Hocus-Pocus/Morgan/README.md

# Morgan
2001 Dodge Ram 2500, 4x4, Extended cab, Long box. Originally equiped with the 360CID V8 engine, automatic transmision and Dana 60 HD rear axle. Drive train changed to 1995 Dodge 488CID (8.0L) V 10 engine, NV4500 5 speed manual transmission, Dana 80 limited slip rear axle, custom built programmable EFI.
