Hocus-Pocus/Morgan/Schematics/1995 8.0L PCM Pinouts.xls

1995 8.0L PCM pin outs
CAV | Circuit | Function
1 | K1 DG/RD 18 AWG | MAP Sensor Signal
2 | K2 TN/BK 18 AWG | Engine Coolant Temperature Signal
3 | A14 RD/WT 16 AWG | Fused B(+)
4 | K4 BK/LB 20 AWG | Sensor Ground
5 | N/C | N/C
6 | K6 VT/WT 20 AWG | 5-Volt Supply
7 | K7 OR 20 AWG | 8-Volt Supply
8 | N/C | N/C
9 | F18 LG/BK 20 AWG | Fused Ignition Switch Output (Start/Run)
10 | T6 OR/WT 20 AWG | Trans Overdrive Switch Sense (output)
11 | Z12 BK/TN 16 AWG | Ground
12 | Z12 BK/TN 16 AWG | Ground
13 | K113 LB/BR 20 AWG | Injector #4 Driver (D) (5+8)
14 | K114 YL/WT20 AWG | Injector #3 Driver (C) (3+6)
15 | K115 TN 20 AWG | Injector #1 Driver (A) (9+4)
16 | K116 WT/DB 20 AWG | Injector #2 Driver (B) (1+10)
17 | K18 RD/YL 18 AWG | Ignition Coil #3 Driver (8+9) (4 pak)
18 | K43 DG/GY 20 AWG | Ignition Coil #5 Driver (2+3) (6 pak)
19 | K19 BK/GY 20 AWG | Ignition Coil #1 Driver (1+6) (6 pak)
20 | K20 DG 18 AWG | Generator Field Driver (control)
21 | K21 BK/RD 16 AWG | Intake Air Temperature Signal
22 | K22 OR/DB 18 AWG | Throttle Position Sensor Signal
23 | K141 TN/WT 18 AWG | Left Oxygen Sensor Signal
24 | K24 GY/BK 20 AWG | Crank Position Sensor Signal
25 | D21 PK 20 AWG | SCI Transmit
26 | N/C | N/C
27 | C20 BR 18 AWG | A/C Switch Sense (request)
28 | N/C | N/C
29 | V40 WT/PK 20 AWG | Brake Switch Sense (output)
30 | T41 BK/WT 20 AWG | Park Neutral Sense Switch
31 | T18 LG/OR 20 AWG | Overdrive Lamp Driver (MIL)
32 | G3 BK/PK 20 AWG | Check Engine Lamp Driver
33 | V36 TN/RD 20 AWG | S/C Vacuum Solenoid Control
34 | C13 DB/OR 20 AWG | A/C Compressor Clutch Relay Control
35 | K35 GY/YL 20 AWG | EGR Solenoid control
36 | G14 PK/BK 18 AWG | Trans Temp Lamp Driver
37 | K137 WT/BK 20 AWG | Dwell Gate Driver (Ign Module 4+7, 5+10)
38 | K138 BR/Or 20 AWG | Dwell Signal (Ign Module 4+7, 5+10)
39 | K39 GY/RD 18 AWG | Idle Air Control Motor #3 Driver (D)
40 | K40 BR/WT 18 AWG | Idle Air Control Motor #1 Driver (B)
41 | K41 BK/DG 18 AWG | Right Oxygen Sensor Signal
42 | T54 VT 18 AWG | Trans Fluid Temp Signal
43 | G21 GY/LB 20 AWG | Tachometer Signal
44 | K44 TN/YL 18 AWG | Camshaft Position Sensor Signal
45 | D20 LG 20 AWG | SCI Receive
46 | N/C | N/C
47 | G7 WT/OR 20 AWG | Vehicle Speed Sensor Signal
48 | V31 BR/RD 20 AWG | S/C Coast/Set Switch Sense
49 | V32 YL/RD 20 AWG | S/C On/Off Switch Sense
50 | V33 WT/LG 20 AWG | S/C Resume Switch Sense
51 | K51 DB/YL 20 AWG | Auto Shutdown Relay Control (also Fuel Pump Relay)
52 | K52 PK/BK 20 AWG | Evap Emission Solenoid Control
53 | V35 LG/RD 20 AWG | S/C Vent Solenoid Control
54 | K54 OR/BK 20 AWG | Torque Converter Clutch Solenoid Control
55 | T60 BR 20 AWG | Overdrive Solenoid Control
56 | G24 GY/PK 20 AWG | Check Engine Lamp (Service Engine?)
57 | A142 DG/OR 16 AWG | Auto Shutdown Relay Output
58 | K1458 LG/BK 20 AWG | Injector #5 Driver (E) (7+2)
59 | K59 VT/BK 18 AWG | Idle Air Control Motor #4 Driver (A)
60 | K60 YL/BK 18 AWG | Idle Air Control Motor #2 Driver (C)
Ignition Control Module
 | K17 DB/T 18AWG | Ignition Coil Driver (5+10) (6 pak)
 | K32 YL/GY 18AWG | Ignition Coil Driver (4+7) (4 pak)
