Hocus-Pocus/Morgan/Schematics/1995 Instrument Cluster Pinouts.xls

1995 Instrument Cluster
C215
1 | G19 22 LG/RD | Warning Lamp Driver | Cut and insulate
2 | G107 22 BK/GY | 4WD Switch Output | Cut and insulate (warning lamps now on remote display)
3 | N/C
4 | G4 22 DB | Fuel Level Sensor Signal | Extend and splice
5 | G60 22 GY/YL | Oil Pressure Gauge Sending Unit | Extend and splice
6 | Z11 20 BK/WT | Ground | Extend and splice
7 | F14 20 LG/YL | Fused Ignition Switch Output (Start-Run) | Extend and splice
8 | G29 22 BK/TN | Low Washer Fluid Indicator Lamp | Cut and insulate (warning lamps now on remote display)
9 | G3 22 BK/PK | Malfunction Indicator Lamp | Cut and insulate
10 | G24 22 GY/PK | SRI Driver | Cut and insulate
11 | G6 22 GY | Oil Pressure Warning Lamp Switch | Cut and insulate (warning lamps now on remote display)
12 | G21 22 GY/LB | Tachometer Signal | Extend and splice
13 | N/C
14 | E2 22 OR | Fused Headlamp Switch Output | Extend and splice
C216
1 | L60 20 TN/BK | Right Front Turn Signal | Extend and splice
2 | G34 18 RD/GY | High Beam Indicator Lamp | Extend and splice
3 | L61 20 LG/YL | Left Front Turn Signal | Extend and splice
4 | G7 20 WT/OR | Vehicle Speed Sensor Signal | Extend and splice
5 | Z3 20 BK/OR | Ground | Extend and splice
6 | R41 18 BK/TN | Airbag System Warning Lamp Driver | Cut and insulate
7 | N/C
8 | G20 22 VT/YL | Engine Coolant Temperature Sending Unit | Extend and splice
9 | Z11 20 BK/WT | Ground | Extend and splice
10 | G11 22 WT/BK | Park Brake Sense Switch | Cut and insulate (warning lamps now on remote display)
11 | G9 22 GY/BK | Brake Warning Lamp Driver | Cut and insulate (warning lamps now on remote display)
12 | G54 22 OR/BK | Upshift Lamp Driver | Cut and insulate
13 | N/C
14 | G13 20 DB/RD | Seat Belt Lamp Driver | Cut and insulate (warning lamps now on remote display)
