Hocus-Pocus/Morgan/Schematics/2001 Instrument Cluster Pinouts.xls

2001 Instrument Cluster Pinouts
C1
1 | N/C
2 | G5 22 DB/WT | Fused Ignition Switch Output (Run-Start) | Extend and splice
3 | G11 22 WT/LG | Park Brake Sense Switch | Extend and splice
4 | Z2 20 BK/LG | Ground | Extend and splice
5 | Z3 20 BK/Or | Ground | Extend and splice
6 | F73 20 YL | Fused B (+) | Extend and splice
7 | N/C
8 | G85 22 OR/BK (Diesel) | Wait To Start Warning Indicator Driver | Cut and insulate
9 | D2 20 WT/BK | CCD Bus (-) | Cut and insulate
10 | D1 20 VT/BR | CCD Bus (-) | Cut and insulate
C2
1 | E2 22 OR | Panel Lamps Feed | Extend and splice
2 | G29 22 BK/WT | Washer Fluid Sense | Extend and splice
3 | G10 22 LG/RD | Seat Belt Sense Switch | Extend and splice
4 | N/C
5 | E17 18 YL/BK | Day Brightness Sense | Cut and insulate
6 | L61 18 LG | Left Turn Signal
7 | G13 22 DB/RD | Chime Request Signal | Cut and insulate
8 | L60 18 TN | Right Turn Signal | Extend and splice
9 | G34 16 RD/GY | High Beam Indicator Driver | Extend and splice
10 | G107 22 GY | 4WD Switch Sense | Extend and splice
