Hocus-Pocus/Morgan/Schematics/2001 to 1995 Instrumnent Cluster Connections.xls

2001 Instrument Cluster harness |  |  |  | 1995 instrument cluster connections
C1
1 | N/C | F17 10 Amp
2 | G5 22 DB/WT | Fused Ignition Switch Output (Run-Start) | Extend and splice | C215 | 7 |  |  | F14 20 LG/YL | Fused Ign Switch Out (Start-Run)
3 | G11 22 WT/LG | Park Brake Sense Switch | Extend and splice |  |  |  |  | ? | Future warning panel
4 | Z2 20 BK/LG | Ground | Extend and splice | C215 | 6 | C216 | 9 | Z11 20 BK/WT | Ground
5 | Z3 20 BK/Or | Ground | Extend and splice | C216 | 5 |  |  | Z3 20 BK/OR | Ground
6 | F73 20 YL | Fused B (+) F14 10 Amp | Extend and splice |  |  |  |  | ? | Future warning panel
7 | N/C
8 | G85 22 OR/BK (Diesel) | Wait To Start Warning Indicator Driver | Cut and insulate
9 | D2 20 WT/BK | CCD Bus (-) | Cut and insulate
10 | D1 20 VT/BR | CCD Bus (-) | Cut and insulate
C2
1 | E2 22 OR | Panel Lamps Feed | Extend and splice | C215 | 14 |  |  | E2 22 OR | Fused Headlamp Switch Output
2 | G29 22 BK/WT | Washer Fluid Sense | Extend and splice |  |  |  |  | ? | Future warning panel
3 | G10 22 LG/RD | Seat Belt Sense Switch | Extend and splice |  |  |  |  | ? | Future warning panel
4 | N/C
5 | E17 18 YL/BK | Day Brightness Sense | Cut and insulate
6 | L61 18 LG | Left Turn Signal | Extend and splice | C216 | 3 |  |  | L61 20 LG/YL | Left Front Turn Signal
7 | G13 22 DB/RD | Chime Request Signal | Cut and insulate
8 | L60 18 TN | Right Turn Signal | Extend and splice | C216 | 1 |  |  | L60 20 TN/BK | Right Front Turn Signal
9 | G34 16 RD/GY | High Beam Indicator Driver | Extend and splice | C216 | 2 |  |  | G34 18 RD/GY | High Beam Indicator Lamp
10 | G107 22 GY | 4WD Switch Sense | Extend and splice |  |  |  |  | ? | Future warning panel
