Hocus-Pocus/Morgan/Schematics/MS3 Main DB37 Connections.xls

MS3 | EP100 | MS3 Name | Billy Name | In/Out | Function | Max Amps | DB15 Pin | INJ Pin | MS colour
1 |  | GND | TPS Gnd | GND | TPS Gnd |  |  |  | #20 Bk (shld)
2 |  | GND | N/C | GND | spare GND
3 |  | SPR1 | N/C | (Comms) | (CANH)
4 |  | SPR2 | N/C | (Comms) | (CANL)
5 |  | SPR3 | N/C | spare | spare
6 |  | SPR4 | N/C | spare | spare
7 |  | GND | CKP Gnd | GND | CKP Gnd |  |  |  | #20 Bk (shld)
8 |  | GND | Sensor Gnd | GND | Sensor Gnd |  |  |  | #20 Bk/W
9 |  | GND | N/C | GND | spare GND
10 |  | GND | N/C | GND | spare GND
11 |  | GND | N/C | GND | spare GND
12 |  | GND | N/C | GND | spare GND
13 |  | GND | N/C | GND | spare GND
14 |  | GND | N/C | GND | spare GND
15 |  | GND | N/C | GND | spare GND
16 |  | GND | N/C | GND | spare GND
17 |  | GND | N/C | GND | spare GND
18 |  | GND | Power Gnd | GND | POWER GROUND |  |  |  | #20 Bk
19 |  | GND | Power Gnd | GND | POWER GROUND |  |  |  | #20 Bk
20 | AD1 | MAT | IAT | In | MAT sensor input |  |  |  | #20 W
21 | AD2 | CLT | ECT | In | CLT sensor input |  |  |  | #20 B
22 | AD3 | TPS | TPS | In | TP sensor input |  |  |  | #20 W (shld)
23 | AD5 | O2 | O2 | In | O2/lambda sensor in |  |  |  | #20 W/R
24 | PT0 | TACH IN | CKP | In | "Crank" Tach input |  |  |  | #20 W (shld)
25 |  | IAC1A | IAC1A | (Out) | (IAC1A) | 0.5A
26 |  | TPSVREF 5V | +5V | Out | 5V supply for TPS | 0.1A | 7 |  | #20 R/Gn
27 |  | IAC1B | IAC1B | (Out) | (IAC1B) | 0.5A
28 |  | +12V In | +12VIn | In | Main Power Feed | <1A | 15 |  | #20 R
29 |  | IAC2A | IAC2A | (Out) | (IAC2A) | 0.5A
30 | PP7 | FIDLE | N/C | Out | Idle valve output | 0.1A
31 |  | IAC2B | IAC2B | (Out) | (IAC2B) | 0.5A
32 |  | INJ1 | N/C | Out | Injector Bank 1 output | 7A
33 |  | INJ1 | Inj 7&2 Cntrl | Out | Injector Bank 1 output | 7A |  | F5 | #20 W/R/B
34 |  | Inj2 | N/C | Out | Injector Bank 2 output | 7A
35 |  | INJ2 | N/C | Out | Injector Bank 2 output | 7A
36 |  | IGN | N/C | (Out) | (High current ignition) | 7A
37 |  | FP (Pump) | ASDR/FPR | Out | Fuel pump relay output | 0.1A |  |  | #20 B/WT
NOTE! MS3 Main DB37 pins 18,19 and MS3X DB37 pins 8,12 common to #18 Bk to engine ground
