Hocus-Pocus/Morgan/Schematics/MS3X DB37 Connections.xls

MS3X | EP100 | MS3X Name | Billy Name | In/Out | Function | Max Amp | DB15 Pin | IGN Pin | INJ Pin | MS colour
1 | PA6 | Inj G | INJ 5&8 Cntrl | Out | Injector G output | 5A | 5 |  | F6 | #20 W/Bk/Gn
2 |  | GND | Fuel Prs Gnd | GND | Fuel Prs Gnd
3 |  | GND | Oil Prs Gnd | GND | Oil Prs Gnd
4 | PA5 | Inj F | INJ Spare Cntrl | Out | Injector F output | 5A | 4 |  | F1
5 | PE2 | Flex | N/C | In | Flex Fuel
6 | PP3 | Boost | Generator Field | Out | Mid current output | 3A
7 | PA4 | Inj E | INJ 3&6 Cntrl | Out | Injector E output | 5A | 13 |  | F7 | #20 W/R/Bk
8 |  | GND | GND | GND | POWER GROUND |  |  |  |  | #20 Bk
9 | PP2 | Idle | 8Cyl CMP Out | Out | Mid current output | 3A |  |  |  | #20 B/Bk (NIS insulate)
10 | PA3 | Inj D | N/C | Out | Injector D output | 5A
11 | PK2 | Launch In | VSS1 | In | Ground switch input |  |  |  |  | #20 Gn/Bk to #20 W/Bk
12 |  | GND | GND | GND | POWER GROUND |  |  |  |  | #20 Bk
13 | PA2 | Inj C | INJ 9&4 Cntrl | Out | Injector C output | 5A | 6 |  | F8 | #20 W/Bk
14 | PB0 | Spark A | IGN 1&6 Cntrl | Out | 0-5V logic spark A output | 0.03A | 11 | S4 |  | #20 B
15 | PB2 | Spark C | IGN 9&8 Cntrl | Out | 0-5V logic spark C output | 0.03A | 10 | S7 |  | #20 B/R
16 | PA1 | Inj B | N/C | Out | Injector B output | 5A
17 |  | GND | CMP Gnd | GND | CMP Gnd |  |  |  |  | #20 Bk (shld)
18 | PB6 | Spark G | N/C | Out | 0-5V logic spark G output | 0.03A
19 | PA0 | Inj A | INJ 1&10 Cntrl | Out | Injector A output | 5A | 14 |  | F4 | #20 W/R
20 | PA7 | Inj H | N/C | Out | Injector H output | 5A
21 | AN13 | Spare ADC | Fuel Prs input | In | 0-5V analog input
22 | AN12 | EGO2 | Oil Prs Input | In | 0-5V analog input
23 | AN11 | EXT_MAP | N/C | In | 0-5V analog input
24 | PP4 | Nitrous 1 | A/C Clutch Relay | Out | Mid current output | 3A |  |  |  | #20 R/Bk/W
25 | PP5 | Nitrous 2 | 10Cyl Tach Out | Out | Mid current output | 3A |  |  |  | #20 B/R
26 | PK0 | Tacho | 8Cyl CKP Out | Out | Mid current output | 3A |  |  |  | #20 B/W (NIS insulate)
27 | PP6 | VVT | N/C | Out | Mid current output | 3A
28 | PH6 | Tableswitch in | A/C Request | In | Ground switch input | <1A |  |  |  | #20 W/Bk
29 | PH7 | Nitrous in | N/C | In | +12V switch input | 0.5A
30 | PT6 | Datalog in | N/C | In | Ground switch input | 0.1A
31 | PT4 | PT4 | N/C | In/Out | 0/5V input or output | 0.02A
32 | PT2 | Cam input | CMP Input | In | Cam' Tach input | 7A |  |  |  | #20 W (shld)
33 | PB1 | Spark B | IGN 10&5 Cntrl | Out | 0-5V logic spark B output | 0.03A | 3 | S8 |  | #20 B/W
34 | PB3 | Spark D | IGN 4&7 Cntrl | Out | 0-5V logic spark D output | 0.03A | 2 | S6 |  | #20 B/Bk
35 | PB4 | Spark E | IGN 3&2 Cntrl | Out | 0-5V logic spark E output | 0.03A | 9 | S5 |  | #20 B/W/Or
36 | PB5 | Spark F | IGN Spare Cntrl | Out | 0-5V logic spark F output | 0.03A | 1 | S1
37 | PB7 | Spark H | N/C | Out | 0-5V logic sparkH output | 0.03A
NOTE! IGN pins S2, S3 common to #16 Bk to engine ground
NOTE! INJ pins F2, F3 common to #16 Bk to engine ground
NOTE! MS3X DB37 Pins 8,12 and MS3 Main DB37 pins 18,19 common to #18 Bk to engine ground
