Hocus-Pocus/Morgan/Hardware/Main board/BOM.xls

Item # | Designator | Qty | Mfg | Mfg Part # | Description | Footprint | Type
1 | U301 | 1 | NXP | MC9S12XEP100CAL | Microcontroller | LQFP112 | SMD
