Hocus-Pocus/Morgan/Schematics/Morgan wiring left in harness.xls

F18 18 LG/BK | Fused Igntion Switch Output (Run-Start) | From 10 amp fuse # 9, feeds PCM and fuel pump relay coil
K4 18 BK/LB | Sensor Ground | Connect to MS sensor ground for fuel pump module, possibly others
T41 18 BK/WT | Park Neutral Switch Sense | From ground side of start relay. Ground this, see page 8W-21-2 for clutch switch connection
A14 14 RD/WT | Fused B (+) | From 20 amp fuse #3, feeds PCM and fuel pump relay contact
G7 18 WT/OR | Vehicle Speed Sensor Signal | From PCM to ABS module (redundant)
K30 18 PK | Transmission Control Relay Control | From transmission control relay coil ground side to PCM (redundant)
C13 18 DB/OR | A/C Compressor Clutch Relay Control | From A/C compressor clutch relay coil ground side to PCM (redundant)
K51 18 DB/Yl | Automatic Shutdown Relay Control | From Automatic shutdown relay coil ground side
V36 18 TN/RD | Speed Control Vacuum Solenoid Control | From PCM to speed control servo (redundant)
V35 18 LG/RD | Speed Control Vent Solenoid Control | From PCM to speed control servo (redundant)
K106 18 WT/DG | Leak Detection Pump Solenoid Control | From leak detection pump solenoid ground side (redundant)
V32 18 YL/RD | Speed Control Supply | From PCM to brake switch to speed control servo (redundant)
A142 14 DG/Or | Automatic Shutdown Relay Output | From Automatic shutdown relay output to Injectors, coils and O2 sensors
T6 18 OR/WT | Overdrive Off Sense Switch | From OD Off switch to PCM (redundant)
K107 18 OR | Leak Detection Pump Switch Sense | From generator source at PCM through contacts in leak detection pump to PCM (redundant)
K118 18 PK/Yl | Battery Temperature Sensor Signal | From PCM to battery temperature switch (redundant)
K31 19 BR/WT | Fuel Pump Relay Control | From fuel pump relay coil ground side
K52 18 PK/WT | Evaporative Emission Solenoid Control | From evaporative emission solenoid ground side (redundant)
C90 18 LG WT | A/C Select Input | From PCM. Parallels output from A/C high pressure switch (redundant)
V40 18 WT/PK | Brake Sense Switch | From PCM to ABS controller (redundant)
T125 18 DB | Generator Source | From generator source on PCM to generator field terminal 2 (redundant)
K226 18 DB/WT | Fuel Level Sensor Signal | From Fuel pump module to PCM
D21 18 PK/DB | SCI Transmit | To Data Link Connector (redundant)
D2 18 Wt/Bk | CCD Bus (-) | See note below
D20 18 DG | SCI Receive | To Data Link Connector (redundant)
D1 18 VT/BR | CCD Bus (+) | See note below
V37 18 RD/LG | Speed Control Switch Signal | From PCM to speed control switches (redundant)
Z12 18 BK/TN | Ground | To Data Link Connector (redundant)
A141 18 DG/WT | Automatic Shutdown Relay Output | To O2 Sensors (redundant)
T16 18 RD | Transmission Control Relay Output | From transmission control relay contact to solenoid assembly (redundant)
L10 18 BR/LG | Fused Ignition Switch Output (Run) | From 10 amp fuse #7 back up lamp supply
T41 18 BK/WT | Park Neutral Position Switch Sense | From ground side of start relay coil to park Neutral switch (redundant)
L1 18 VT/BK | Backup Lamp Feed | To back up lamps
C3 22 DB/BK | A/C Compressor Clutch | Output from A/C Compressor Clutch Relay
NOTE! CCD bus links PCM, Air Bag Control, Radio, Overhead Consol, Central Timer Module, ABS Module and Instrument Cluster
