Hocus-Pocus/Morgan/Hardware/Auxiliary board/BPEM488CWaux.kicad_pcb

## KiCad design Hardware/Auxiliary board/BPEM488CWaux.kicad_pcb (2022-11-16)

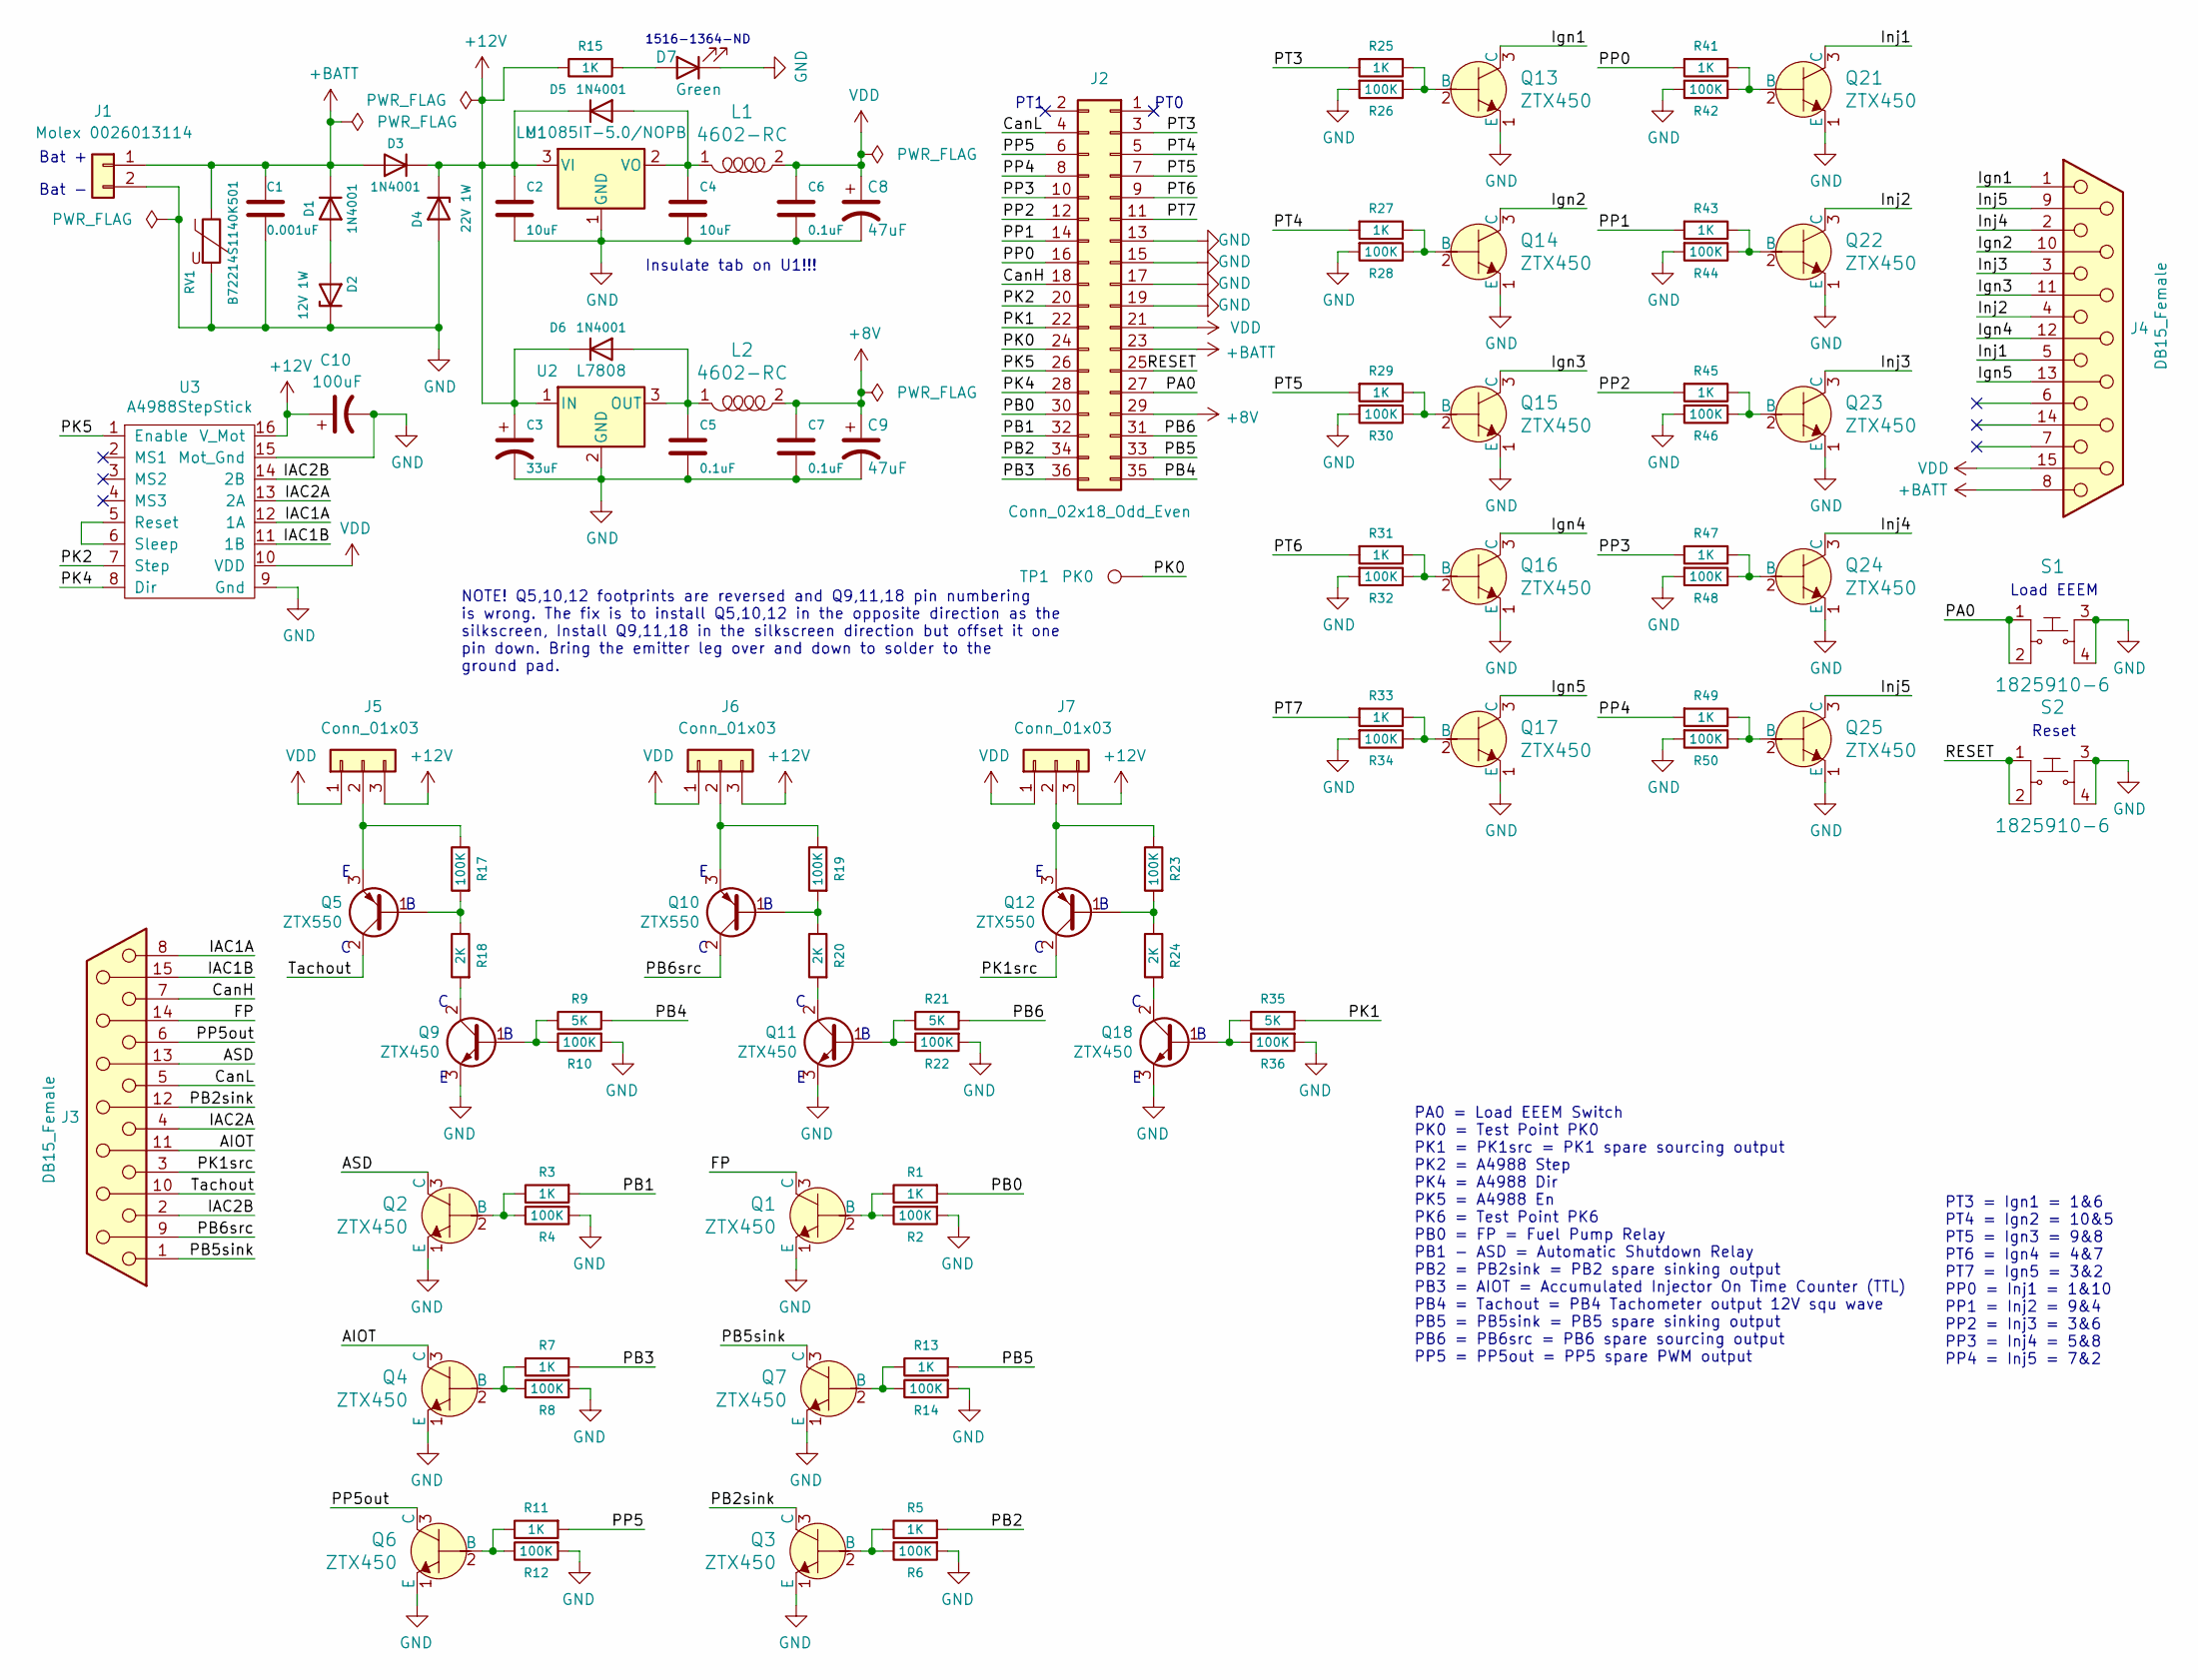
[picture p1: schematic BPEM488CWaux.sch]

Parts:
C1: 0.001uF; C_Disc_D3.8mm_W2.6mm_P2.50mm; Digikey 399-13913-2-ND
C2, C4: 10uF; C_Disc_D5.0mm_W2.5mm_P2.50mm; Digikey 399-13950-ND
C3: 33uF; CP_Radial_Tantal_D8.0mm_P5.00mm; Digikey 399-3591-ND
C5, C6, C7: 0.1uF; C_Disc_D5.0mm_W2.5mm_P2.50mm; Digikey 399-4264-ND
C8, C9: 47uF; CP_Radial_Tantal_D8.0mm_P5.00mm; Digikey 399-3596-ND
C10: 100uF; CP_Radial_Tantal_D8.0mm_P5.00mm; Digikey 399-3596-ND
D1, D3, D5, D6: 1N4001; D_DO-41_SOD81_P7.62mm_Horizontal; Digikey 1N4001DICT-ND
D2: 12V 1W; D_DO-41_SOD81_P7.62mm_Horizontal; Digikey 1727-3635-2-ND
D4: 22V 1W; D_DO-41_SOD81_P7.62mm_Horizontal; Digikey MAZ222000GTR-ND
D7: Green; LED_D5.0mm; Digikey 1516-1364-ND
J1: Molex 0026013114; Molex_Mini-Fit_Jr_5569-02A2_2x01_P4.20mm_Horizontal; Digikey WM14505-ND
J2: Conn_02x18_Odd_Even; PinSocket_2x18_P2.54mm_Vertical
J3, J4: DB15_Female; DSUB-15_Female_Horizontal_P2.77x2.84mm_EdgePinOffset7.70mm_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; Digikey A32123-ND
J5, J6, J7: Conn_01x03; PinHeader_1x03_P2.54mm_Vertical
L1, L2: 4602-RC; L_Axial_L16.0mm_D6.3mm_P25.40mm_Horizontal_Fastron_VHBCC; Digikey 4602-RC-ND
Q1, Q2, Q3, Q4, Q6, Q7, Q13, Q14, Q15, Q16, Q17, Q21, Q22, Q23, Q24, Q25: ZTX450; MPN ZTX450; Digi-Key_PN ZTX450-ND
Q5, Q10, Q12: ZTX550
Q9, Q11, Q18: ZTX450
R1, R3, R5, R7, R11, R13, R15, R25, R27, R29, R31, R33, R41, R43, R45, R47, R49: 1K; R_Axial_DIN0207_L6.3mm_D2.5mm_P10.16mm_Horizontal; Digikey 1.00KXBK-ND
R2, R4, R6, R8, R10, R12, R14, R22, R26, R28, R30, R32, R34, R36, R42, R44, R46, R48, R50: 100K; R_Axial_DIN0207_L6.3mm_D2.5mm_P10.16mm_Horizontal; Digikey 100KXBK-ND
R9, R21, R35: 5K; R_Axial_DIN0207_L6.3mm_D2.5mm_P10.16mm_Horizontal; Digikey 1.00KXBK-ND
R17, R19, R23: 100K; R_Axial_DIN0207_L6.3mm_D2.5mm_P10.16mm_Horizontal; Digikey 1.00KXBK-ND
R18, R20, R24: 2K; R_Axial_DIN0207_L6.3mm_D2.5mm_P10.16mm_Horizontal; Digikey 1.00KXBK-ND
RV1: B72214S1140K501; RV_Disc_D15.5mm_W3.9mm_P7.5mm; Digikey 495-2057-ND
S1, S2: 1825910-6; Switch_Tactile_THT_6x6mm; MPN 1825910-6; Digi-Key_PN 450-1650-ND
TP1: PK0; PinHeader_1x01_P2.54mm_Vertical
U1: LM1085IT-5.0/NOPB; LM1085
U2: L7808
U3: A4988StepStick

Connections:
+8V: C7.1, C9.1, J2.29, L2.2
+12V: C2.1, C3.1, C10.1, D3.1 (K), D4.1 (K), D5.1 (K), D6.1 (K), J5.3, J6.3, J7.3, R15.1, U1.3 (VI), U2.1 (IN), U3.16 (V_Mot)
+BATT: C1.1, D1.1 (K), D3.2 (A), J1.1, J2.23, J4.8, RV1.1
/AIOT: J3.11 (P111), Q4.3 (C)
/ASD: J3.13, Q2.3 (C)
/CanH: J2.18, J3.7
/CanL: J2.4, J3.5
/FP: J3.14, Q1.3 (C)
/IAC1A: J3.8, U3.12 (1A)
/IAC1B: J3.15, U3.11 (1B)
/IAC2A: J3.4, U3.13 (2A)
/IAC2B: J3.2, U3.14 (2B)
/Ign1: J4.1, Q13.3 (C)
/Ign2: J4.10, Q14.3 (C)
/Ign3: J4.11 (P111), Q15.3 (C)
/Ign4: J4.12, Q16.3 (C)
/Ign5: J4.13, Q17.3 (C)
/Inj1: J4.5, Q21.3 (C)
/Inj2: J4.4, Q22.3 (C)
/Inj3: J4.3, Q23.3 (C)
/Inj4: J4.2, Q24.3 (C)
/Inj5: J4.9, Q25.3 (C)
/PA0: J2.27, S1.1, S1.2
/PB0: J2.30, R1.2
/PB1: J2.32, R3.2
/PB2: J2.34, R5.2
/PB2sink: J3.12, Q3.3 (C)
/PB3: J2.36, R7.2
/PB4: J2.35, R9.2
/PB5: J2.33, R13.2
/PB5sink: J3.1, Q7.3 (C)
/PB6: J2.31, R21.2
/PB6src: J3.9, Q10.2 (C)
/PK0: J2.24, TP1.1
/PK1: J2.22, R35.2
/PK1src: J3.3, Q12.2 (C)
/PK2: J2.20, U3.7 (Step)
/PK4: J2.28, U3.8 (Dir)
/PK5: J2.26, U3.1 (Enable)
/PP0: J2.16, R41.2
/PP1: J2.14, R43.2
/PP2: J2.12, R45.2
/PP3: J2.10, R47.2
/PP4: J2.8, R49.2
/PP5: J2.6, R11.2
/PP5out: J3.6, Q6.3 (C)
/PT3: J2.3, R25.2
/PT4: J2.5, R27.2
/PT5: J2.7, R29.2
/PT6: J2.9, R31.2
/PT7: J2.11, R33.2
/RESET: J2.25, S2.1, S2.2
/Tachout: J3.10, Q5.2 (C)
GND: C1.2, C2.2, C3.2, C4.2, C5.2, C6.2, C7.2, C8.2, C9.2, C10.2, D2.1 (K), D4.2 (A), D7.1 (K), J1.2, J2.13, J2.15, J2.17, J2.19, Q1.1 (E), Q2.1 (E), Q3.1 (E), Q4.1 (E), Q6.1 (E), Q7.1 (E), Q9.3 (E), Q11.3 (E), Q13.1 (E), Q14.1 (E), Q15.1 (E), Q16.1 (E), Q17.1 (E), Q18.3 (E), Q21.1 (E), Q22.1 (E), Q23.1 (E), Q24.1 (E), Q25.1 (E), R2.2, R4.2, R6.2, R8.2, R10.2, R12.2, R14.2, R22.2, R26.2, R28.2, R30.2, R32.2, R34.2, R36.2, R42.2, R44.2, R46.2, R48.2, R50.2, RV1.2, S1.3, S1.4, S2.3, S2.4, U1.1 (GND), U2.2 (GND), U3.9 (Gnd), U3.15 (Mot_Gnd)
unnamed: C4.1, D5.2 (A), L1.1, U1.2 (VO)
unnamed: C5.1, D6.2 (A), L2.1, U2.3 (OUT)
unnamed: D1.2 (A), D2.2 (A)
unnamed: D7.2 (A), R15.2
unnamed: J5.2, Q5.3 (E), R17.1
unnamed: J6.2, Q10.3 (E), R19.1
unnamed: J7.2, Q12.3 (E), R23.1
unnamed: Q1.2 (B), R1.1, R2.1
unnamed: Q2.2 (B), R3.1, R4.1
unnamed: Q3.2 (B), R5.1, R6.1
unnamed: Q4.2 (B), R7.1, R8.1
unnamed: Q5.1 (B), R17.2, R18.1
unnamed: Q6.2 (B), R11.1, R12.1
unnamed: Q7.2 (B), R13.1, R14.1
unnamed: Q9.1 (B), R9.1, R10.1
unnamed: Q9.2 (C), R18.2
unnamed: Q10.1 (B), R19.2, R20.1
unnamed: Q11.1 (B), R21.1, R22.1
unnamed: Q11.2 (C), R20.2
unnamed: Q12.1 (B), R23.2, R24.1
unnamed: Q13.2 (B), R25.1, R26.1
unnamed: Q14.2 (B), R27.1, R28.1
unnamed: Q15.2 (B), R29.1, R30.1
unnamed: Q16.2 (B), R31.1, R32.1
unnamed: Q17.2 (B), R33.1, R34.1
unnamed: Q18.1 (B), R35.1, R36.1
unnamed: Q18.2 (C), R24.2
unnamed: Q21.2 (B), R41.1, R42.1
unnamed: Q22.2 (B), R43.1, R44.1
unnamed: Q23.2 (B), R45.1, R46.1
unnamed: Q24.2 (B), R47.1, R48.1
unnamed: Q25.2 (B), R49.1, R50.1
unnamed: U3.5 (Reset), U3.6 (Sleep)
VDD: C6.1, C8.1, J2.21, J4.15, J5.1, J6.1, J7.1, L1.2, U3.10 (VDD)

Notes on the sheet:
Load EEEM
Reset
Bat -
Bat +
PA0 = Load EEEM Switch PK0 = Test Point PK0 PK1 = PK1src = PK1 spare sourcing output PK2 = A4988 Step PK4 = A4988 Dir PK5 = A4988 En PK6 = Test Point PK6 PB0 = FP = Fuel Pump Relay PB1 - ASD = Automatic Shutdown Relay PB2 = PB2sink = PB2 spare sinking output PB3 = AIOT = Accumulated Injector On Tim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
PT3 = Ign1 = 1&6 PT4 = Ign2 = 10&5 PT5 = Ign3 = 9&8 PT6 = Ign4 = 4&7 PT7 = Ign5 = 3&2 PP0 = Inj1 = 1&10 PP1 = Inj2 = 9&4 PP2 = Inj3 = 3&6 PP3 = Inj4 = 5&8 PP4 = Inj5 = 7&2
Insulate tab on U1!!!
PT0
PT1
1516-1364-ND
NOTE! Q5,10,12 footprints are reversed and Q9,11,18 pin numbering is wrong. The fix is to install Q5,10,12 in the opposite direction as the silkscreen, Install Q9,11,18 in the silkscreen direction but offset it one pin down. Bring the emitter leg over and down to solder to the ground pad.

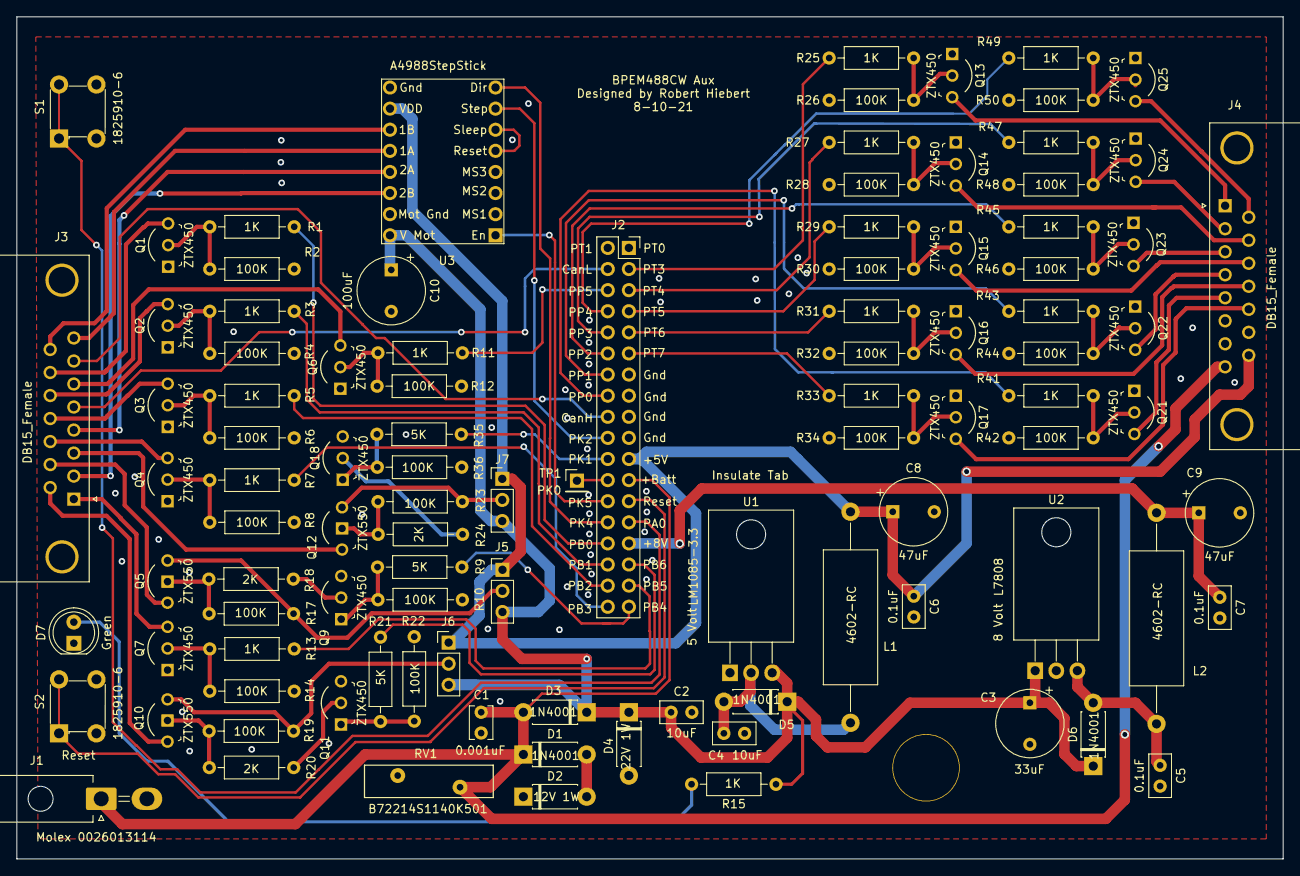
[picture p2: board BPEM488CWaux.kicad_pcb from above]

Board: 2 copper layers, 152.4 x 101.3 mm, 100 parts (0 on the bottom side), 88 nets.
