Hocus-Pocus/Morgan/Hardware/Main board/BPEM488CW.kicad_pcb

## KiCad design Hardware/Main board/BPEM488CW.kicad_pcb (2022-11-16)

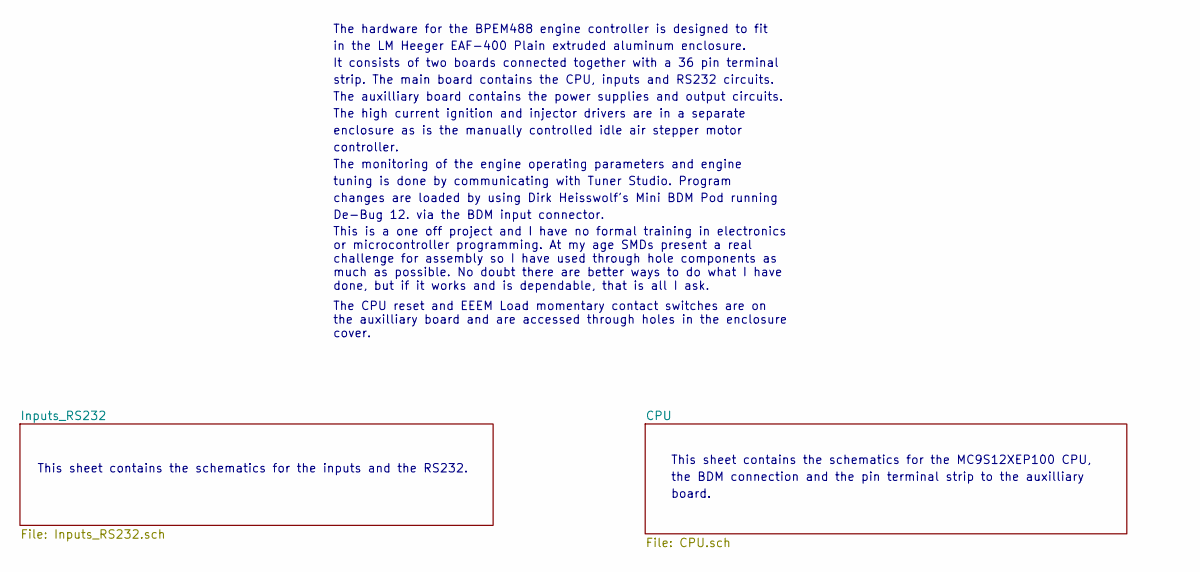
[picture p3: schematic BPEM488CW.sch]

Notes on the sheet:
This sheet contains the schematics for the MC9S12XEP100 CPU,
the BDM connection and the pin terminal strip to the auxilliary
board.
This sheet contains the schematics for the inputs and the RS232.
The hardware for the BPEM488 engine controller is designed to fit
in the LM Heeger EAF-400 Plain extruded aluminum enclosure.
It consists of two boards connected together with a 36 pin terminal
strip. The main board contains the CPU, inputs and RS232 circuits.
The auxilliary board contains the power supplies and output circuits.
The high current ignition and injector drivers are in a separate
enclosure as is the manually controlled idle air stepper motor
controller.
The monitoring of the engine operating parameters and engine
tuning is done by communicating with Tuner Studio. Program
changes are loaded by using Dirk Heisswolf's Mini BDM Pod running
De-Bug 12. via the BDM input connector.
This is a one off project and I have no formal training in electronics or microcontroller programming. At my age SMDs present a real challenge for assembly so I have used through hole components as much as possible. No doubt there are better ways to do what I have done, but if it works and is depen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
The CPU reset and EEEM Load momentary contact switches are on the auxilliary board and are accessed through holes in the enclosure cover.

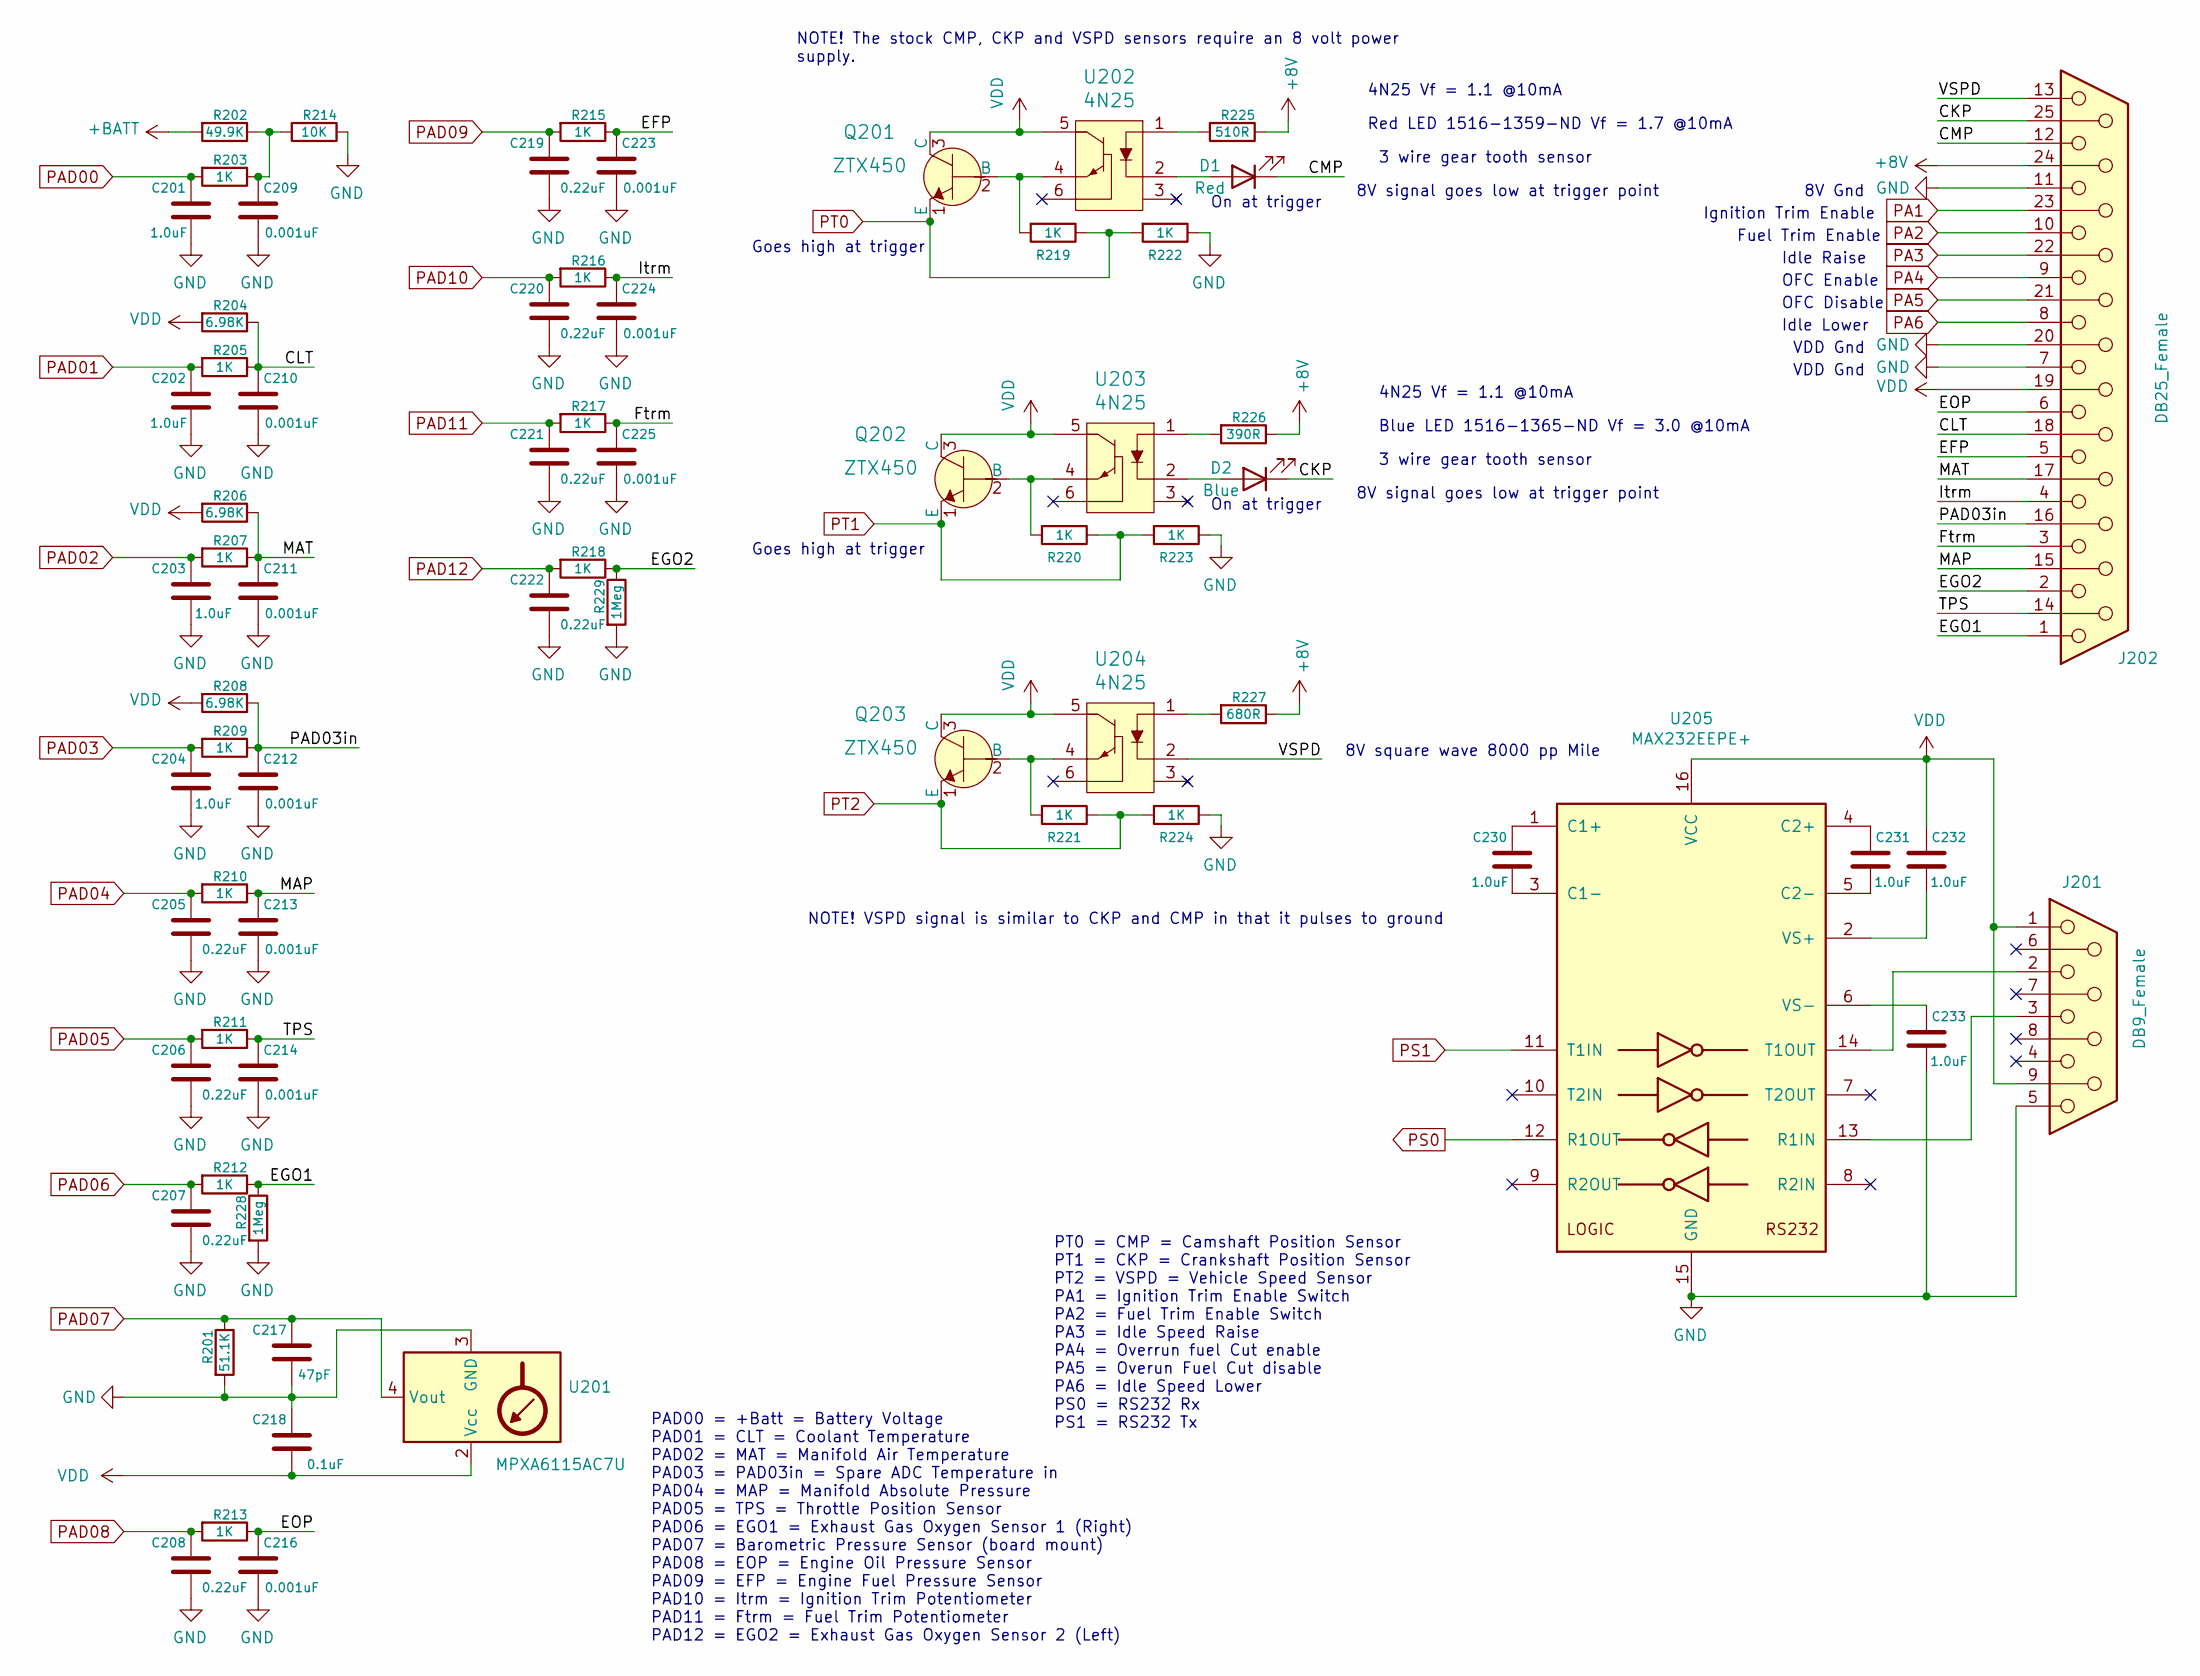
[picture p4: schematic Inputs_RS232.sch, BPEM488CW]

Parts:
C201, C202, C203, C204, C230, C231, C232, C233: 1.0uF; C_Disc_D3.8mm_W2.6mm_P2.50mm; Digikey 399-9714-ND
C205, C206, C207, C208, C219, C220, C221, C222: 0.22uF; C_Disc_D5.0mm_W2.5mm_P2.50mm; Digikey 399-4289-ND
C209, C210, C211, C212, C213, C214, C216, C223, C224, C225: 0.001uF; C_Disc_D3.8mm_W2.6mm_P2.50mm; Digikey 399-4144-ND
C217: 47pF; C_Disc_D3.8mm_W2.6mm_P2.50mm; Digikey 399-9737-ND
C218: 0.1uF; C_Disc_D5.0mm_W2.5mm_P2.50mm; Digikey 399-4264-ND
D1: Red; LED_D3.0mm
D2: Blue; LED_D3.0mm
J201: DB9_Female; DSUB-9_Female_Horizontal_P2.77x2.84mm_EdgePinOffset9.90mm_H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; Digikey A132512-ND
J202: DB25_Female; DSUB-25_Female_Horizontal_P2.77x2.84mm_EdgePinOffset7.70mm_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; Digikey AE10935-ND
Q201, Q202, Q203: ZTX450; TO-92-3_Formed_Leads; MPN ZTX450; Digi-Key_PN ZTX450-ND
R201: 51.1K; R_Axial_DIN0207_L6.3mm_D2.5mm_P10.16mm_Horizontal; Digikey 51.0KXBK-ND
R202: 49.9K; R_Axial_DIN0207_L6.3mm_D2.5mm_P10.16mm_Horizontal; Digikey 49.9KXBK-ND
R203, R205, R207, R209, R210, R211, R212, R213, R215, R216, R217, R218, R219, R220, R221, R222, R223, R224: 1K; R_Axial_DIN0207_L6.3mm_D2.5mm_P10.16mm_Horizontal; Digikey 1.00KXBK-ND
R204, R206, R208: 6.98K; R_Axial_DIN0207_L6.3mm_D2.5mm_P10.16mm_Horizontal; Digikey 6.98KXBK-ND
R214: 10K; R_Axial_DIN0207_L6.3mm_D2.5mm_P10.16mm_Horizontal; Digikey 10.0KXBK-ND
R225: 510R; R_Axial_DIN0207_L6.3mm_D2.5mm_P10.16mm_Horizontal; Digikey 200XBK-ND
R226: 390R; R_Axial_DIN0207_L6.3mm_D2.5mm_P10.16mm_Horizontal; Digikey 200XBK-ND
R227: 680R; R_Axial_DIN0207_L6.3mm_D2.5mm_P10.16mm_Horizontal; Digikey 200XBK-ND
R228, R229: 1Meg; R_Axial_DIN0207_L6.3mm_D2.5mm_P10.16mm_Horizontal; Digikey 1.00MXBK-ND
U201: MPXA6115AC7U; Digikey 568-13767-ND
U202, U203, U204: 4N25; DIP-6_W7.62mm; MPN 4N25; Digi-Key_PN 160-1300-5-ND
U205: MAX232EEPE+; DIP-16_W7.62mm; Digikey MAX232EEPE+-ND

Connections:
+8V: J202.24, R225.1, R226.1, R227.1; also elsewhere on the board
+BATT: R202.2; also elsewhere on the board
/Inputs_RS232/CKP: D2.1 (K), J202.25
/Inputs_RS232/CLT: C210.2, J202.18, R204.1, R205.1
/Inputs_RS232/CMP: D1.1 (K), J202.12
/Inputs_RS232/EFP: C223.2, J202.5, R215.1
/Inputs_RS232/EGO1: J202.1, R212.1, R228.1
/Inputs_RS232/EGO2: J202.2, R218.1, R229.1
/Inputs_RS232/EOP: C216.2, J202.6, R213.1
/Inputs_RS232/Ftrm: C225.2, J202.3, R217.1
/Inputs_RS232/Itrm: C224.2, J202.4, R216.1
/Inputs_RS232/MAP: C213.2, J202.15, R210.1
/Inputs_RS232/MAT: C211.2, J202.17, R206.1, R207.1
/Inputs_RS232/PAD03in: C212.2, J202.16, R208.1, R209.1
/Inputs_RS232/TPS: C214.2, J202.14, R211.1
/Inputs_RS232/VSPD: J202.13, U204.2
GND: C201.1, C202.1, C203.1, C204.1, C205.1, C206.1, C207.1, C208.1, C209.1, C210.1, C211.1, C212.1, C213.1, C214.1, C216.1, C217.1, C218.2, C219.1, C220.1, C221.1, C222.1, C223.1, C224.1, C225.1, C233.1, J201.5, J202.7, J202.11, J202.20, R201.2, R214.1, R222.1, R223.1, R224.1, R228.2, R229.2, U201.3 (GND), U205.15 (GND); also elsewhere on the board
unnamed: C209.2, R202.1, R203.1, R214.2
unnamed: C230.1, U205.3 (C1-)
unnamed: C230.2, U205.1 (C1+)
unnamed: C231.1, U205.5 (C2-)
unnamed: C231.2, U205.4 (C2+)
unnamed: C232.1, U205.2 (VS+)
unnamed: C233.2, U205.6 (VS-)
unnamed: D1.2 (A), U202.2
unnamed: D2.2 (A), U203.2
unnamed: J201.2, U205.14 (T1OUT)
unnamed: J201.3, U205.13 (R1IN)
unnamed: Q201.2 (B), R219.2, U202.4
unnamed: Q202.2 (B), R220.2, U203.4
unnamed: Q203.2 (B), R221.2, U204.4
unnamed: R225.2, U202.1
unnamed: R226.2, U203.1
unnamed: R227.2, U204.1
PA1: J202.23; also elsewhere on the board
PA2: J202.10; also elsewhere on the board
PA3: J202.22; also elsewhere on the board
PA4: J202.9; also elsewhere on the board
PA5: J202.21; also elsewhere on the board
PA6: J202.8; also elsewhere on the board
PAD00: C201.2, R203.2; also elsewhere on the board
PAD01: C202.2, R205.2; also elsewhere on the board
PAD02: C203.2, R207.2; also elsewhere on the board
PAD03: C204.2, R209.2; also elsewhere on the board
PAD04: C205.2, R210.2; also elsewhere on the board
PAD05: C206.2, R211.2; also elsewhere on the board
PAD06: C207.2, R212.2; also elsewhere on the board
PAD07: C217.2, R201.1, U201.4 (Vout); also elsewhere on the board
PAD08: C208.2, R213.2; also elsewhere on the board
PAD09: C219.2, R215.2; also elsewhere on the board
PAD10: C220.2, R216.2; also elsewhere on the board
PAD11: C221.2, R217.2; also elsewhere on the board
PAD12: C222.2, R218.2; also elsewhere on the board
PS0: U205.12 (R1OUT); also elsewhere on the board
PS1: U205.11 (T1IN); also elsewhere on the board
PT0: Q201.1 (E), R219.1, R222.2; also elsewhere on the board
PT1: Q202.1 (E), R220.1, R223.2; also elsewhere on the board
PT2: Q203.1 (E), R221.1, R224.2; also elsewhere on the board
VDD: C218.1, C232.2, J201.1, J201.9, J202.19, Q201.3 (C), Q202.3 (C), Q203.3 (C), R204.2, R206.2, R208.2, U201.2 (Vcc), U202.5, U203.5, U204.5, U205.16 (VCC); also elsewhere on the board

Notes on the sheet:
Fuel Trim Enable
Ignition Trim Enable
Idle Raise
OFC Enable
OFC Disable
Idle Lower
8V Gnd
VDD Gnd
NOTE! The stock CMP, CKP and VSPD sensors require an 8 volt power supply.
8V signal goes low at trigger point
8V square wave 8000 pp Mile
Goes high at trigger
PT0 = CMP = Camshaft Position Sensor PT1 = CKP = Crankshaft Position Sensor PT2 = VSPD = Vehicle Speed Sensor PA1 = Ignition Trim Enable Switch PA2 = Fuel Trim Enable Switch PA3 = Idle Speed Raise PA4 = Overrun fuel Cut enable PA5 = Overun Fuel Cut disable PA6 = Idle Speed Lower PS0 = RS232 Rx PS1 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
PAD00 = +Batt = Battery Voltage PAD01 = CLT = Coolant Temperature PAD02 = MAT = Manifold Air Temperature PAD03 = PAD03in = Spare ADC Temperature in PAD04 = MAP = Manifold Absolute Pressure PAD05 = TPS = Throttle Position Sensor PAD06 = EGO1 = Exhaust Gas Oxygen Sensor 1 (Right) PAD07 = Barometric P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
3 wire gear tooth sensor
On at trigger
Red LED 1516-1359-ND Vf = 1.7 @10mA
Blue LED 1516-1365-ND Vf = 3.0 @10mA
4N25 Vf = 1.1 @10mA
NOTE! VSPD signal is similar to CKP and CMP in that it pulses to ground

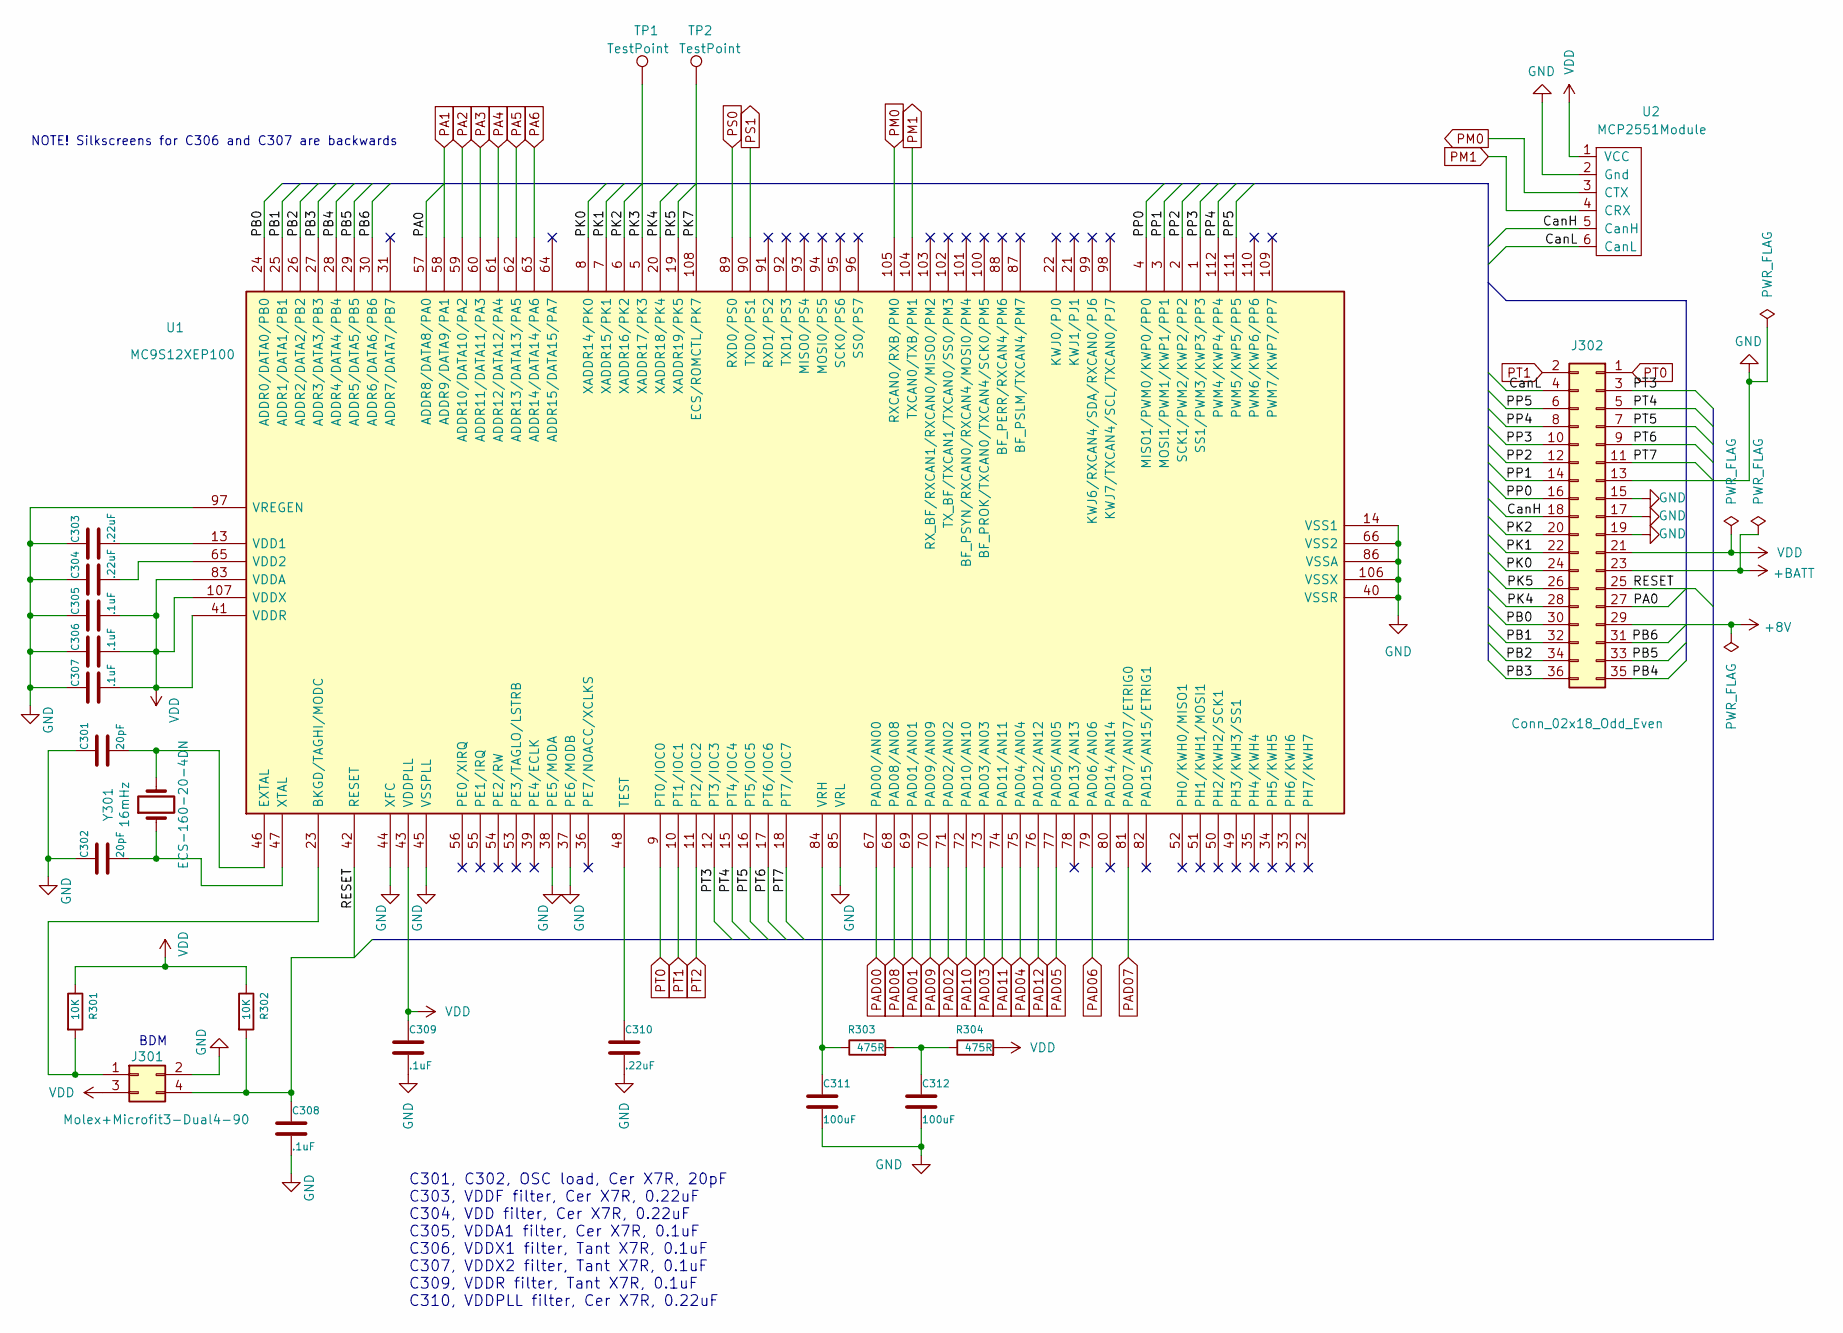
[picture p5: schematic CPU.sch, BPEM488CW]

Parts:
C301, C302: 20pF; C_Disc_D3.8mm_W2.6mm_P2.50mm; Digikey 478-7724-ND
C303, C304, C310: .22uF; C_Disc_D5.0mm_W2.5mm_P2.50mm; Digikey 399-4288-ND
C305, C308: .1uF; C_Disc_D5.0mm_W2.5mm_P2.50mm; Digikey 399-4264-ND
C306, C307, C309: .1uF; CP_Radial_Tantal_D4.5mm_P2.50mm; Digikey 399-3526-ND
C311, C312: 100uF; CP_Radial_D8.0mm_P5.00mm; Digikey 478-6063-ND
J301: Molex+Microfit3-Dual4-90; Molex-Microfit3-Dual4-90; Digikey WM2679-ND
J302: Conn_02x18_Odd_Even; PinSocket_2x18_P2.54mm_Vertical; Digikey S7128-ND
R301, R302: 10K; R_Axial_DIN0207_L6.3mm_D2.5mm_P10.16mm_Horizontal; Digikey 10.0KXBK-ND
R303, R304: 475R; R_Axial_DIN0207_L6.3mm_D2.5mm_P10.16mm_Horizontal; Digikey 475XBK-ND
TP1, TP2: TestPoint; PinHeader_1x01_P2.54mm_Vertical
U1: MC9S12XEP100
U2: MCP2551Module
Y301: 16mHz; Crystal_HC49-4H_Vertical; Digikey X192-ND

Connections:
+8V: J302.29; also elsewhere on the board
+BATT: J302.23; also elsewhere on the board
/CPU/CanH: J302.18, U2.5 (CanH)
/CPU/CanL: J302.4, U2.6 (CanL)
/CPU/PA0: J302.27, U1.57 (ADDR8/DATA8/PA0)
/CPU/PB0: J302.30, U1.24 (ADDR0/DATA0/PB0)
/CPU/PB1: J302.32, U1.25 (ADDR1/DATA1/PB1)
/CPU/PB2: J302.34, U1.26 (ADDR2/DATA2/PB2)
/CPU/PB3: J302.36, U1.27 (ADDR3/DATA3/PB3)
/CPU/PB4: J302.35, U1.28 (ADDR4/DATA4/PB4)
/CPU/PB5: J302.33, U1.29 (ADDR5/DATA5/PB5)
/CPU/PB6: J302.31, U1.30 (ADDR6/DATA6/PB6)
/CPU/PK0: J302.24, U1.8 (XADDR14/PK0)
/CPU/PK1: J302.22, U1.7 (XADDR15/PK1)
/CPU/PK2: J302.20, U1.6 (XADDR16/PK2)
/CPU/PK3: TP1.1, U1.5 (XADDR17/PK3)
/CPU/PK4: J302.28, U1.20 (XADDR18/PK4)
/CPU/PK5: J302.26, U1.19 (XADDR19/PK5)
/CPU/PK7: TP2.1, U1.108 (ECS/ROMCTL/PK7)
/CPU/PP0: J302.16, U1.4 (MISO1/PWM0/KWP0/PP0)
/CPU/PP1: J302.14, U1.3 (MOSI1/PWM1/KWP1/PP1)
/CPU/PP2: J302.12, U1.2 (SCK1/PWM2/KWP2/PP2)
/CPU/PP3: J302.10, U1.1 (SS1/PWM3/KWP3/PP3)
/CPU/PP4: J302.8, U1.112 (PWM4/KWP4/PP4)
/CPU/PP5: J302.6, U1.111 (PWM5/KWP5/PP5)
/CPU/PT3: J302.3, U1.12 (PT3/IOC3)
/CPU/PT4: J302.5, U1.15 (PT4/IOC4)
/CPU/PT5: J302.7, U1.16 (PT5/IOC5)
/CPU/PT6: J302.9, U1.17 (PT6/IOC6)
/CPU/PT7: J302.11, U1.18 (PT7/IOC7)
/CPU/RESET: C308.1, J301.4, J302.25, R302.2, U1.42 (RESET)
GND: C301.1, C302.1, C303.1, C304.1, C305.1, C306.1, C307.1, C308.2, C309.2, C310.2, C311.2, C312.2, J301.2, J302.13, J302.15, J302.17, J302.19, U1.14 (VSS1), U1.37 (PE6/MODB), U1.38 (PE5/MODA), U1.40 (VSSR), U1.44 (XFC), U1.45 (VSSPLL), U1.66 (VSS2), U1.85 (VRL), U1.86 (VSSA), U1.97 (VREGEN), U1.106 (VSSX), U2.2 (Gnd); also elsewhere on the board
unnamed: C301.2, U1.46 (EXTAL), Y301.2
unnamed: C302.2, U1.47 (XTAL), Y301.1
unnamed: C303.2, U1.13 (VDD1)
unnamed: C304.2, U1.65 (VDD2)
unnamed: C310.1, U1.48 (TEST)
unnamed: C311.1, R303.1, U1.84 (VRH)
unnamed: C312.1, R303.2, R304.1
unnamed: J301.1, R301.2, U1.23 (BKGD/TAGHI/MODC)
PA1: U1.58 (ADDR9/DATA9/PA1); also elsewhere on the board
PA2: U1.59 (ADDR10/DATA10/PA2); also elsewhere on the board
PA3: U1.60 (ADDR11/DATA11/PA3); also elsewhere on the board
PA4: U1.61 (ADDR12/DATA12/PA4); also elsewhere on the board
PA5: U1.62 (ADDR13/DATA13/PA5); also elsewhere on the board
PA6: U1.63 (ADDR14/DATA14/PA6); also elsewhere on the board
PAD00: U1.67 (PAD00/AN00); also elsewhere on the board
PAD01: U1.69 (PAD01/AN01); also elsewhere on the board
PAD02: U1.71 (PAD02/AN02); also elsewhere on the board
PAD03: U1.73 (PAD03/AN03); also elsewhere on the board
PAD04: U1.75 (PAD04/AN04); also elsewhere on the board
PAD05: U1.77 (PAD05/AN05); also elsewhere on the board
PAD06: U1.79 (PAD06/AN06); also elsewhere on the board
PAD07: U1.81 (PAD07/AN07/ETRIG0); also elsewhere on the board
PAD08: U1.68 (PAD08/AN08); also elsewhere on the board
PAD09: U1.70 (PAD09/AN09); also elsewhere on the board
PAD10: U1.72 (PAD10/AN10); also elsewhere on the board
PAD11: U1.74 (PAD11/AN11); also elsewhere on the board
PAD12: U1.76 (PAD12/AN12); also elsewhere on the board
PM0: U1.105 (RXCAN0/RXB/PM0), U2.3 (CTX)
PM1: U1.104 (TXCAN0/TXB/PM1), U2.4 (CRX)
PS0: U1.89 (RXD0/PS0); also elsewhere on the board
PS1: U1.90 (TXD0/PS1); also elsewhere on the board
PT0: J302.1, U1.9 (PT0/IOC0); also elsewhere on the board
PT1: J302.2, U1.10 (PT1/IOC1); also elsewhere on the board
PT2: U1.11 (PT2/IOC2); also elsewhere on the board
VDD: C305.2, C306.2, C307.2, C309.1, J301.3, J302.21, R301.1, R302.1, R304.2, U1.41 (VDDR), U1.43 (VDDPLL), U1.83 (VDDA), U1.107 (VDDX), U2.1 (VCC); also elsewhere on the board

Notes on the sheet:
C301, C302, OSC load, Cer X7R, 20pF C303, VDDF filter, Cer X7R, 0.22uF C304, VDD filter, Cer X7R, 0.22uF C305, VDDA1 filter, Cer X7R, 0.1uF C306, VDDX1 filter, Tant X7R, 0.1uF C307, VDDX2 filter, Tant X7R, 0.1uF C309, VDDR filter, Tant X7R, 0.1uF C310, VDDPLL filter, Cer X7R, 0.22uF
BDM
NOTE! Silkscreens for C306 and C307 are backwards

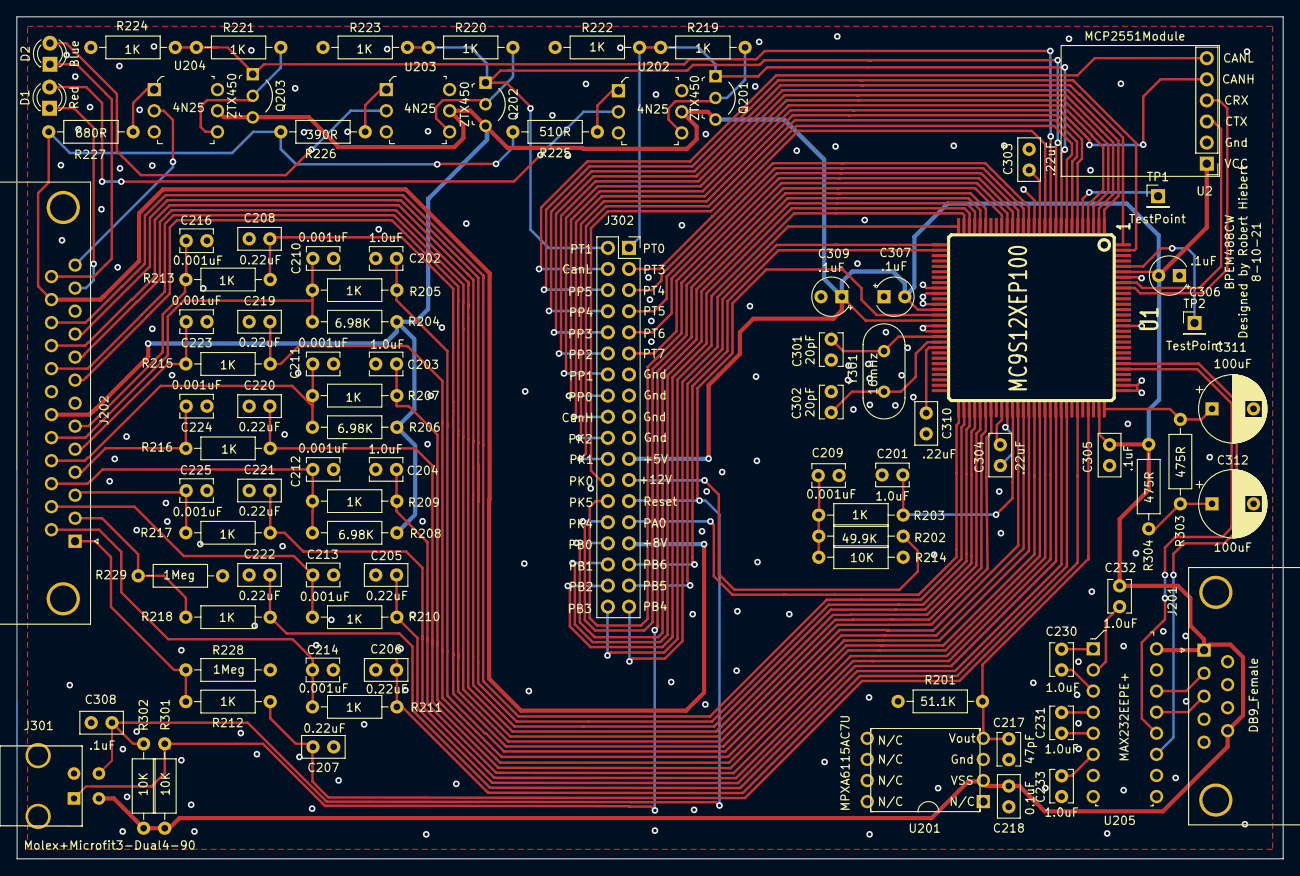
[picture p6: board BPEM488CW.kicad_pcb from above]

Board: 2 copper layers, 152.4 x 101.3 mm, 92 parts (0 on the bottom side), 98 nets.
